Saturday-365/ECT-BSPD_HQU_CZCD/BSPD_Project/BOM_001_Schematic1_2025-08-26.xlsx

No. | Quantity | Comment | Designator | Footprint | Value | Manufacturer Part | Manufacturer | Supplier Part | Supplier | Actuator Color | Actuator Style | Actuator/Cap Color
1 | 9 | 100nF | C1,C2,C5,C6,C7,C8,C9,C11,C13 | C0603 | 100nF | CGA0603X7R104K500JT | HRE(芯声) | C6119867 | LCSC
2 | 2 | 10uF | C10,C12 | C0603 | 10uF | CGA0603X5R106K100JT | HRE(芯声) | C6119842 | LCSC
3 | 2 | 100uF | C14,C15 | CAP-SMD_BD6.3-L6.6-W6.6-LS7.4-FD | 100uF | RVT100UF35V67RV0034 | KNSCHA(科尼盛) | C2836442 | LCSC
4 | 1 | M4 | D1 | SMA_L4.3-W2.6-LS5.0-RD |  | M4 | 宏迦橙 | C18199095 | LCSC
5 | 1 | nSMD005 | F1 | F1206 |  | nSMD005 | 台湾陆海 | C70064 | LCSC
6 | 3 | WJ500V-5.08-2P | P1,P2,P3 | CONN-TH_2P-P5.00_WJ500V-5.08-2P |  | WJ500V-5.08-2P | KANGNEX(康奈克斯电气) | C8465 | LCSC
7 | 2 | BSS138 | Q1,Q3 | SOT-23-3_L2.9-W1.3-P1.90-LS2.4-BR |  | BSS138 | 宏嘉诚 | C7420339 | LCSC
8 | 1 | BSS84 | Q2 | SOT-23-3_L2.9-W1.3-P1.90-LS2.4-BR-1 |  | BSS84 | 宏嘉诚 | C7420340 | LCSC
9 | 7 | 100kΩ | R1,R3,R5,R7,R27,R39,R41 | R0603 | 100kΩ | 0603WAF1003T5E | UNI-ROYAL(厚声) | C25803 | LCSC
10 | 4 | 1kΩ | R2,R4,R6,R8 | R0603 | 1kΩ | 0603WAF1001T5E | UNI-ROYAL(厚声) | C21190 | LCSC
11 | 10 | 10kΩ | R9,R17,R18,R19,R20,R29,R30,R31,R38,R40 | R0603 | 10kΩ | 0603WAF1002T5E | UNI-ROYAL(厚声) | C25804 | LCSC
12 | 2 | 10kΩ | R14,R16 | RES-ADJ-TH_3P-L10.0-W10.0-P2.50-L | 10kΩ | 3296W-1-103 | BOCHEN(博晨) | C118954 | LCSC
13 | 1 | 40.2kΩ | R21 | R0603 | 40.2kΩ | FRC0603F4022TS | FOJAN(富捷) | C2933218 | LCSC
14 | 2 | 39kΩ | R26,R28 | R0603 | 39kΩ | 0603WAF3902T5E | UNI-ROYAL(厚声) | C23153 | LCSC
15 | 2 | 100Ω | R32,R37 | R0603 | 100Ω | 0603WAF1000T5E | UNI-ROYAL(厚声) | C22775 | LCSC
16 | 1 | 1MΩ | R35 | R0603 | 1MΩ | 0603WAF1004T5E | UNI-ROYAL(厚声) | C22935 | LCSC
17 | 1 | 750kΩ | R36 | R0603 | 750kΩ | FRC0603J754 TS | FOJAN(富捷) | C2907201 | LCSC
18 | 1 | SRD-12VDC-SL-C | RELAY1 | RELAY-TH_SRD-XXVDC-XL-C |  | SRD-12VDC-SL-C | 松乐 | C30431 | LCSC
19 | 4 | LM393DR | U1,U5,U10,U11 | SOIC-8_L5.0-W4.0-P1.27-LS6.0-BL |  | LM393DR | TI(德州仪器) | C67470 | LCSC
20 | 2 | 78M05 | U7,U12 | TO-252-2_L6.6-W6.1-P4.57-LS9.9-BR-CW |  | 78M05 | UMW(友台半导体) | C347278 | LCSC
21 | 2 | SN74LVC1G00DBVR(UMW) | U8,U9 | SOT-23-5_L2.9-W1.6-P0.95-LS2.8-BL |  | SN74LVC1G00DBVR(UMW) | UMW(友台半导体) | C434066 | LCSC
