Saturday-365/ECT-BSPD_HQU_CZCD/BSPD_Project/速迫BSPD_V2.0原理图(1).pdf

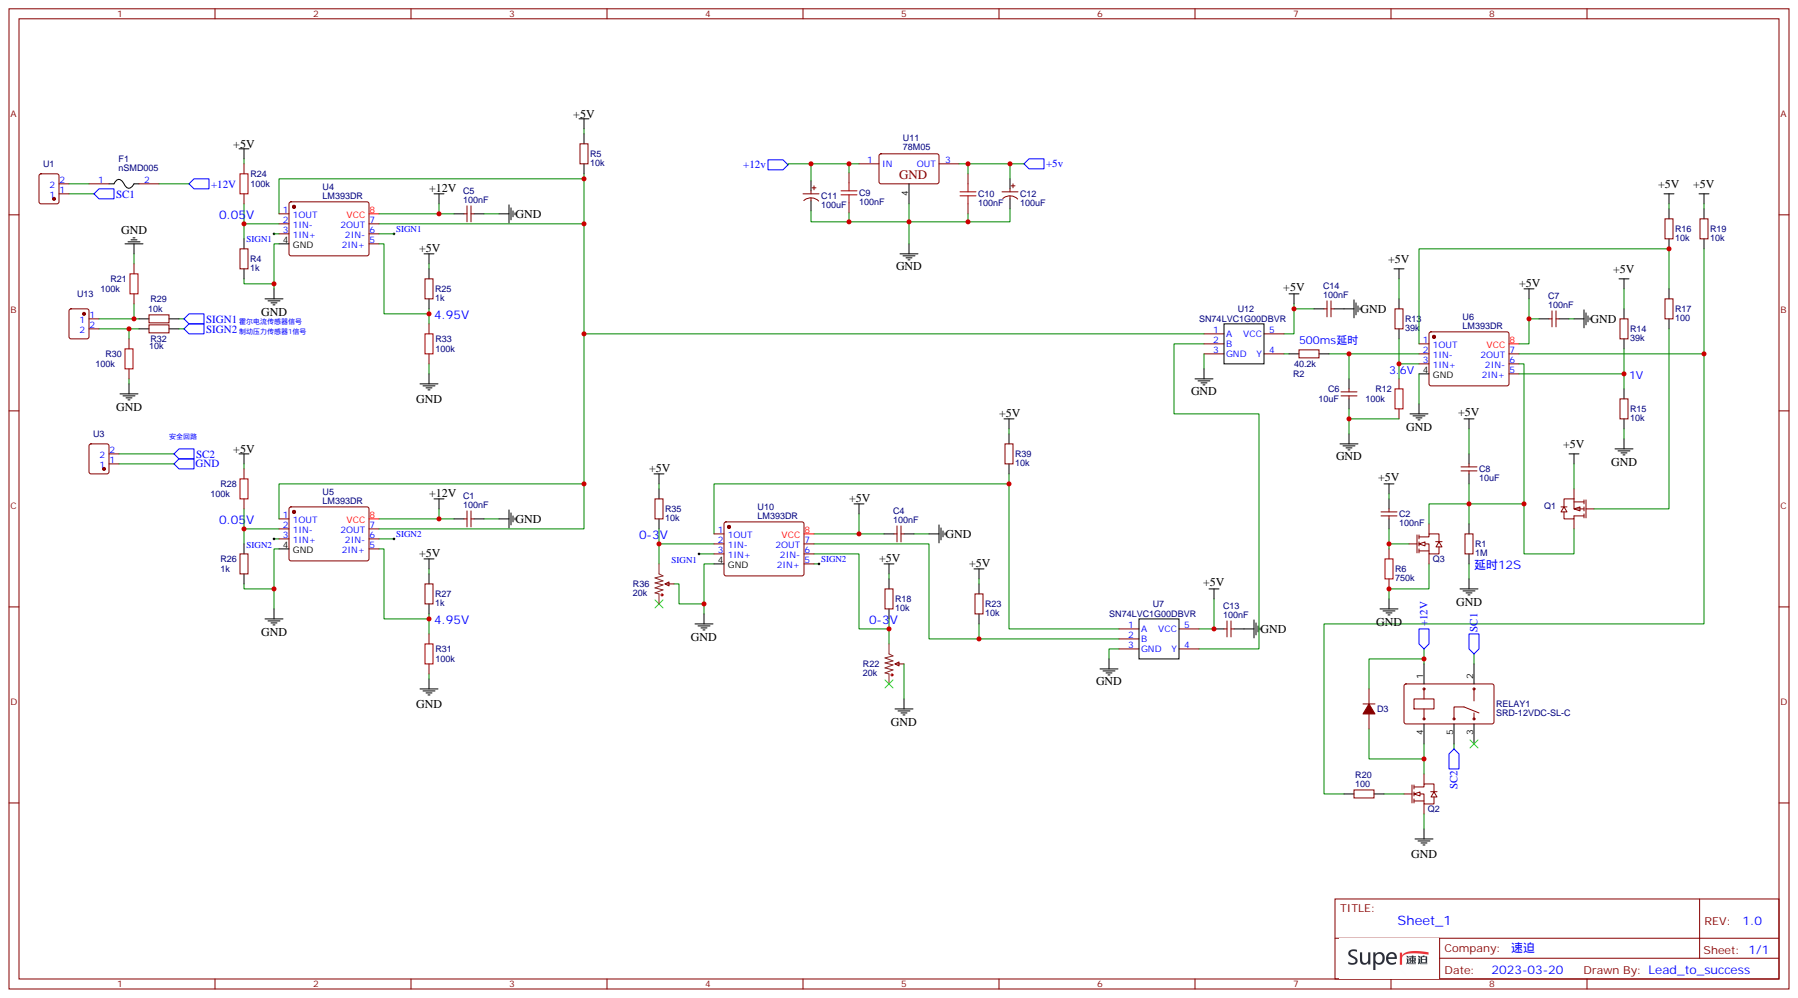
[picture p9: page 1]
