Saturday-365/ECT-BSPD_HQU_CZCD/(list of files, drawings)

Other design files:
BSPD_Project/ProPrj_BSPD_2025-08-26.epro
